senski/cyanostat/Construction Manual for the CyanoStat.pdf

# Construction Manual for the CyanoStat

### Author: Stephanie Conley Date: June 14, 2014

## Table for Contents

Equipment and Pricing (page 2-9)

Printed Circuit Board (PCB) and Wiring (page 10-13)

## Equipment and Pricing

- Six (6) solenoid pinch valves.

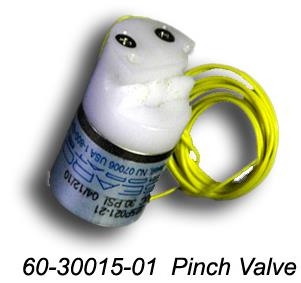
[picture p27: figure]

Source: http://www.cytekdev.com/products/Pinch-Valve-Normally-Open.html Price: $140 new, consider buying used on Ebay.

This is the model and type I use. There are other types of pinch valves that may be purchased at a lower price. Their quality may differ.

- Six (6) test tubes of medium size.

This website provides a good resource of sizes, quantities, and prices. Test tubes can be bought in bulk.

http://www.lcmlab.com/18x150mm_Pyrex_Glass_Test_Tubes_p/206-0007w.htm

- Rubber tubing to facilitate nutrient transport into the test tubes.

Price: 10 for $1.10
This website is a good resource for tubing. Cheaper options may be found elsewhere.
http://www.hometrainingtools.com/tubing-4-8-mm-vinyl-2-long/p/CE-TUBEPLS

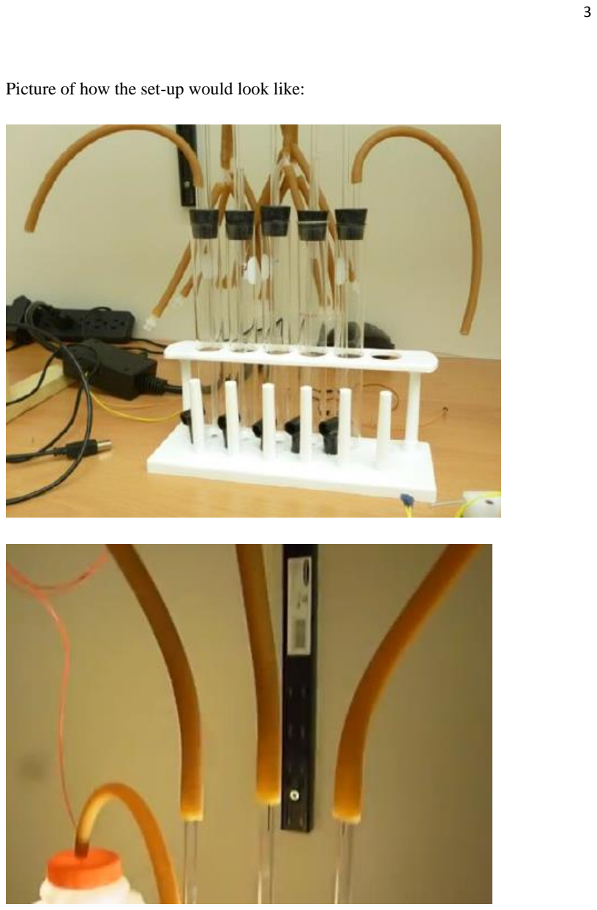
[picture p28: page 3]

Picture of how the set-up would look like:

- Six (6) Y connectors

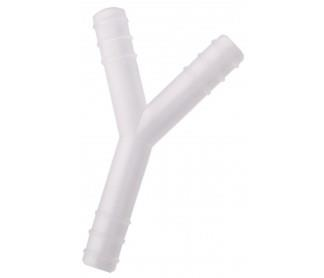
[picture p29: figure]

Price: 10 for $2.20
http://www.hometrainingtools.com/tubing-y-connector-plastic/p/CE-TUBEY/?gclid=CMa9o4rH-r4CFZFufgodZFsAKw (http://www.hometrainingtools.com/tubing-y-connector-plastic/p/CE-TUBEY/)
- Nine (9) long glass tubes. Keep six long and cut the other three in half. Distribute

those among the six test tubes. They serve as an outlet point for extra fluid. Price: 40 for $0.40

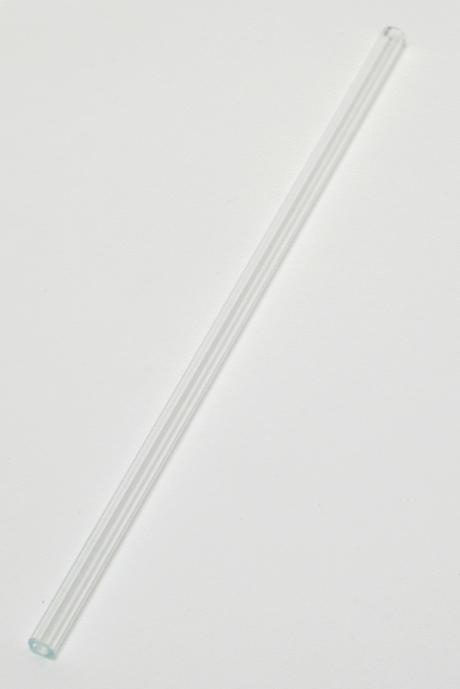
[picture p30: figure]

- Six (6) rubber stoppers with tube entry

Price: 10 for $0.25

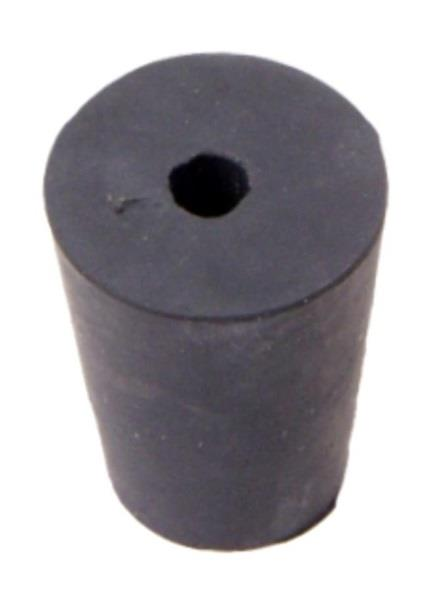
[picture p31: figure]

- Six (6) photoresistor sensors

Price: 10-49 for $0.86
http://www.adafruit.com/products/161

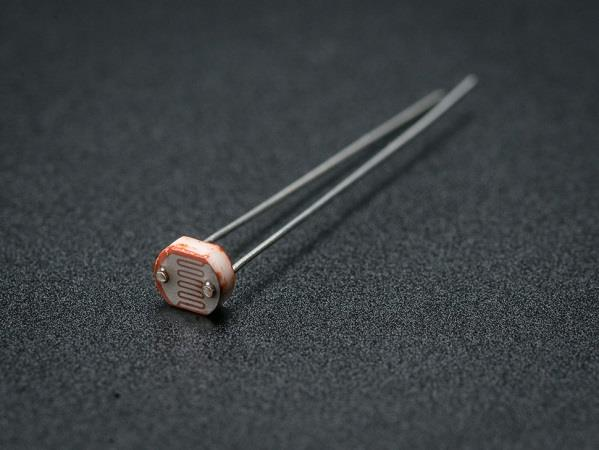
[picture p32: figure]

- Wiring (different colors are the best option)

Price: 1-9 for $15.95
https://www.adafruit.com/products/1311

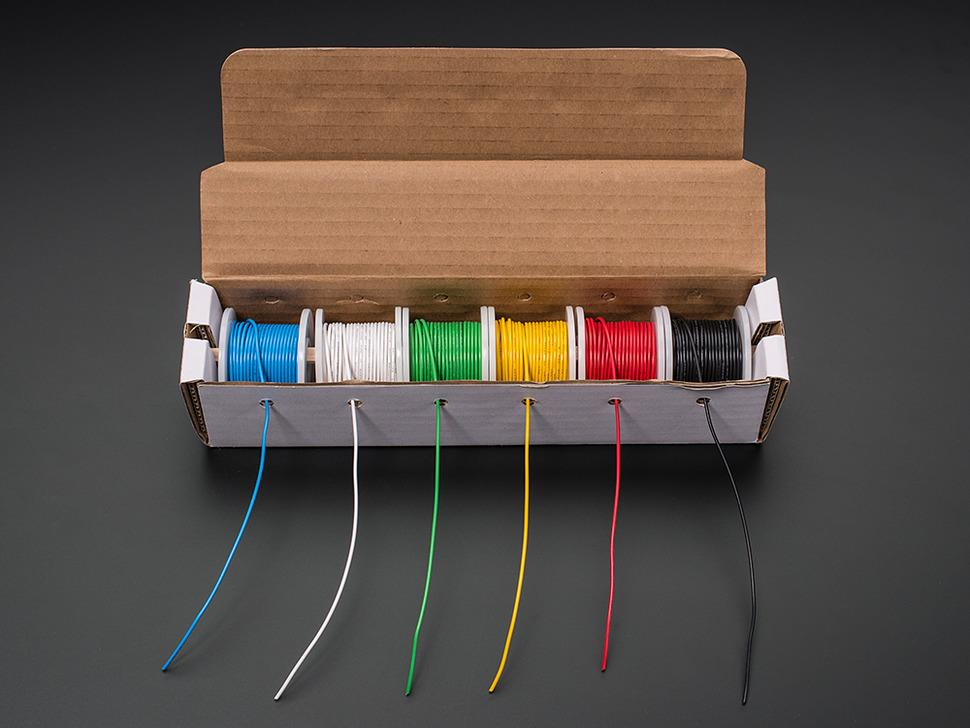
[picture p33: figure]

- One (1) Arduino Mega 2560

Price: $45.95

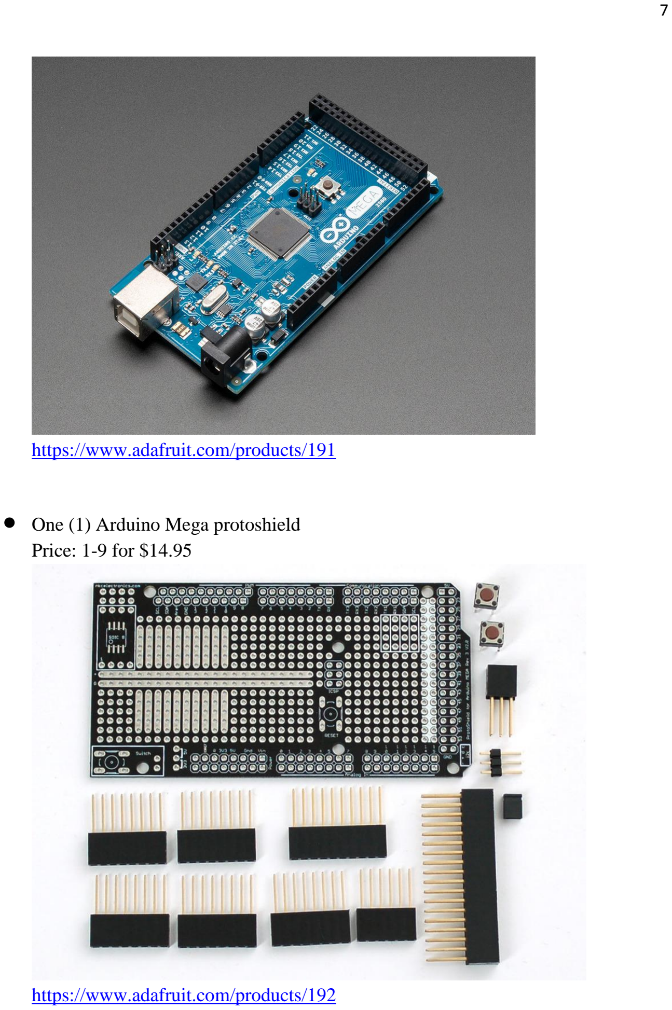
[picture p34: page 7]

https://www.adafruit.com/products/191

- One (1) Arduino Mega protoshield

Price: 1-9 for $14.95

https://www.adafruit.com/products/192

- One (1) Arduino Ethernet Shield R3 with Micro SD Connector

Price: $45.00

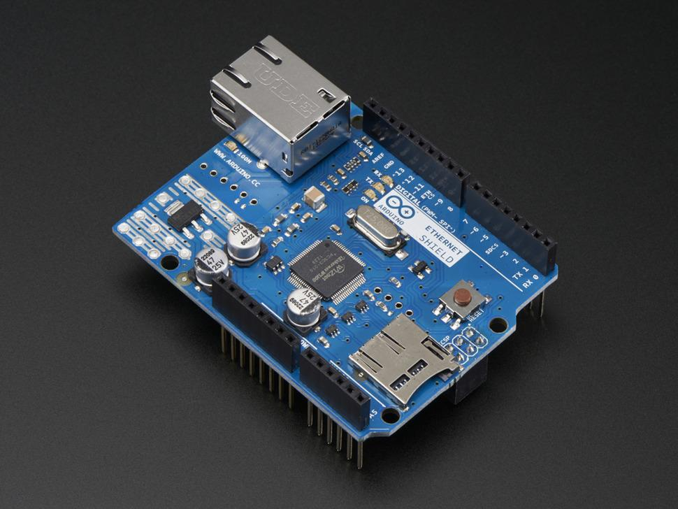
[picture p35: figure]

https://www.adafruit.com/products/201

## Printed Circuit Board (PCB) and Wiring

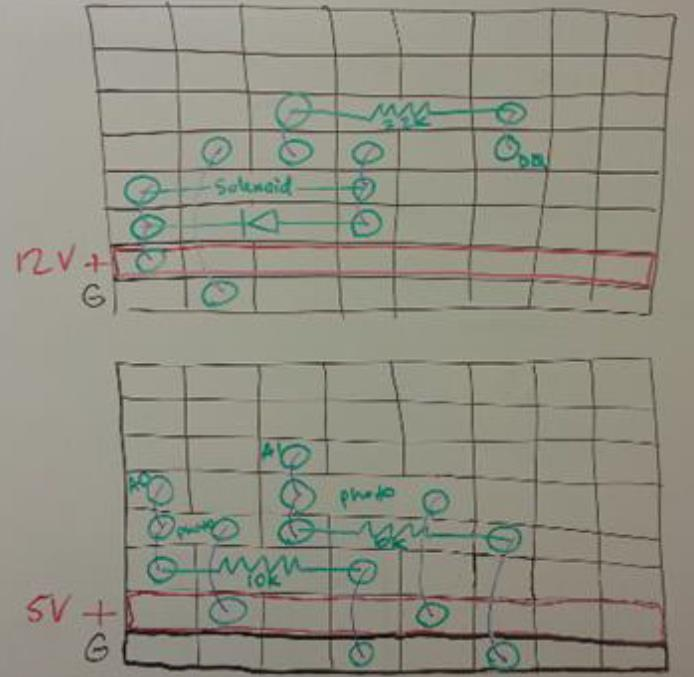
[picture p36: figure]

Solenoid pinch valve schematic for pinning.

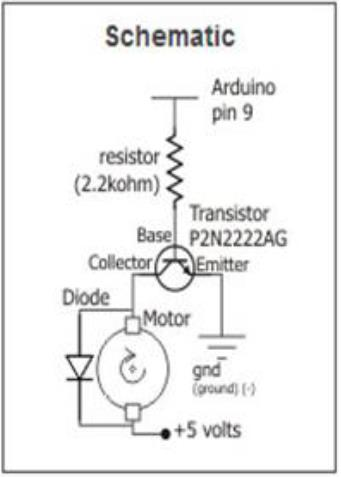
[picture p37: figure]

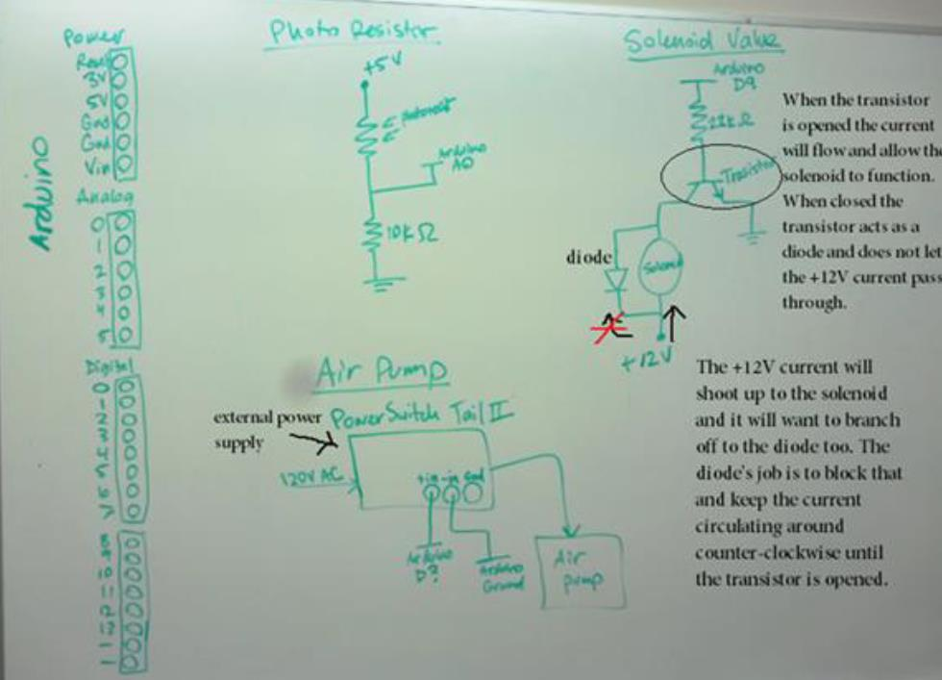
[picture p38: figure]

Figure 3 is a schematic for the photoresistor sensors and figure 4 is the schematic for solenoid pinch valve.

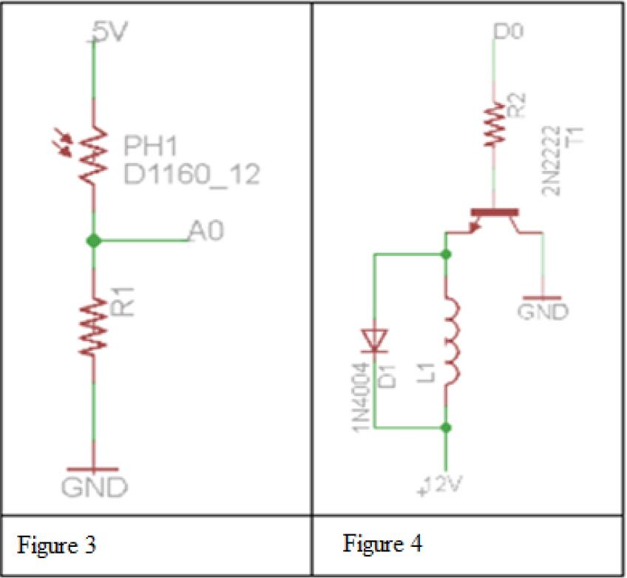
[picture p39: figure]

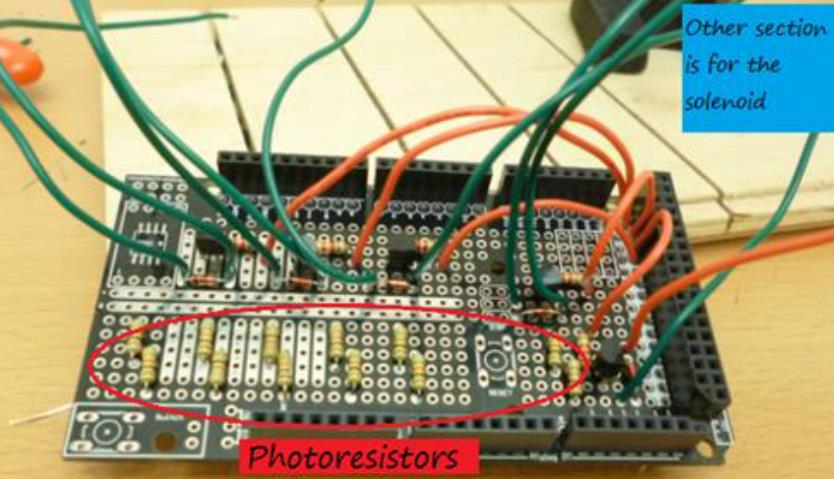
[picture p40: figure]
